fiozera/FZsatellite/README.md

# FZsatellite
Um satélite PocketQube Open Hardware

Projeto desenvolvido em colaboração com:

- Jonathan Querubina <https://github.com/chr0nu5>
- Pedro Kaled <https://github.com/pedrokdc>
- Edson Pavoni

Licensed under CERN-OHL-S v2 or later
