fiozera/FZsatellite/3d_models/suport_mod.stl

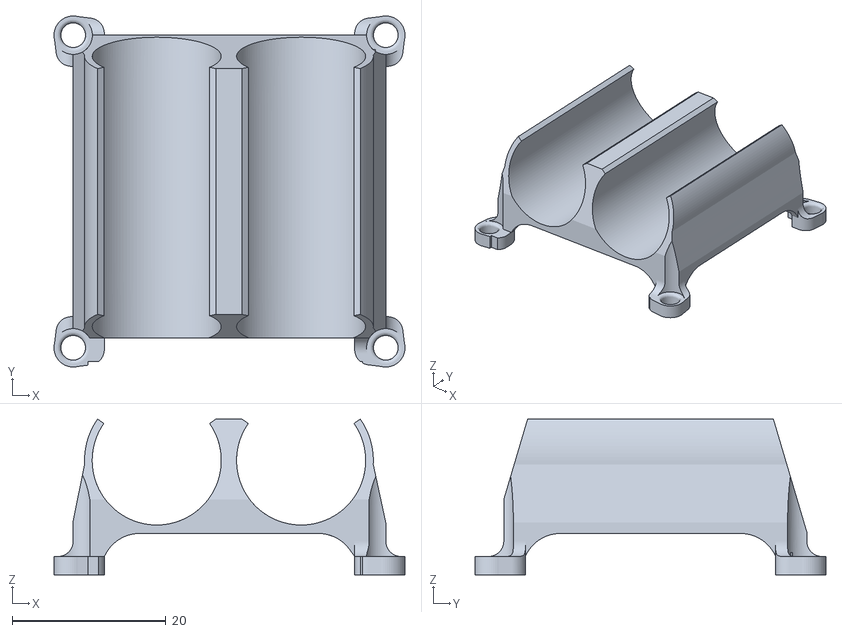
[picture p1: CAD file, 2022-11-08]
3d_models/suport_mod.stl
45.7 x 45.7 x 20.3
