fiozera/FZsatellite/kicad_files/PANEL-COMPLETE.kicad_pcb

## KiCad design kicad_files/PANEL-COMPLETE.kicad_pcb (2022-12-25)

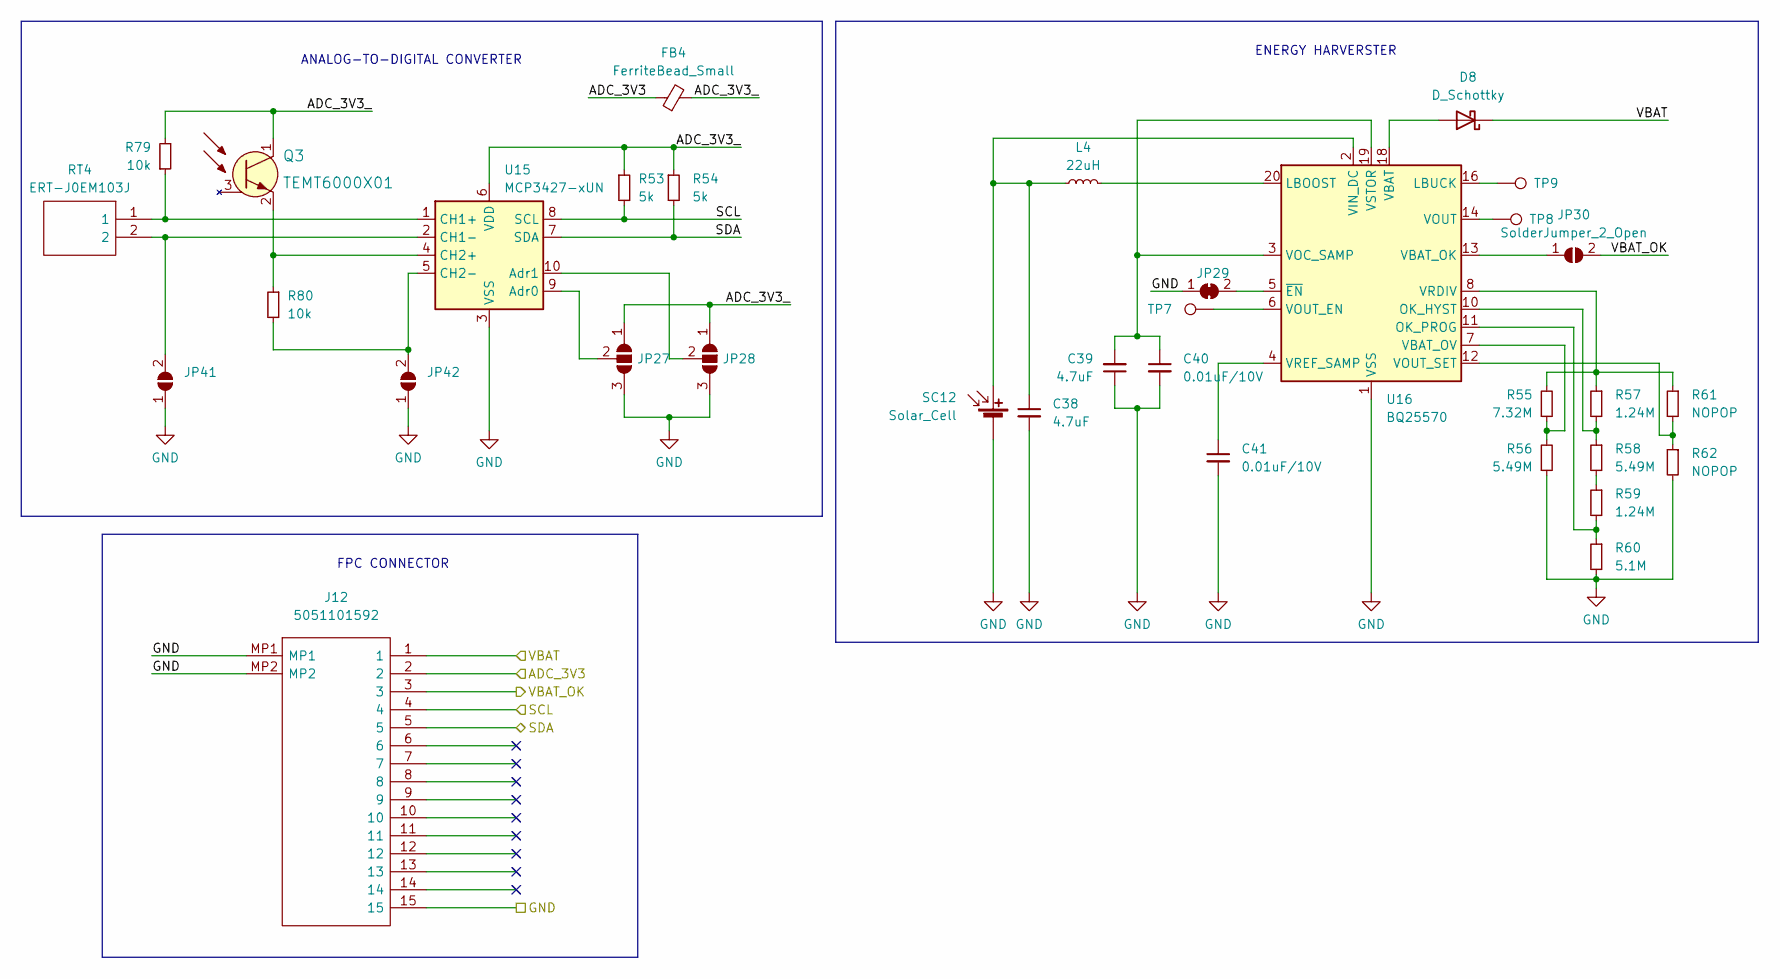
[picture p2: schematic eps_b.kicad_sch, FZSatellite]

Parts:
C38, C39: 4.7uF; C_0805_2012Metric
C40, C41: 0.01uF/10V; C_0402_1005Metric; Mouser Part 581-0402ZC103MAT2A
D8: D_Schottky; D_SOD-323
FB4: FerriteBead_Small; L_0603_1608Metric
J12: 5051101592; Manufacturer_Part_Number 5051101592
JP27, JP28: SolderJumper_3_Open; SolderJumper-3_P1.3mm_Open_RoundedPad1.0x1.5mm
JP29: SolderJumper_2_Bridged; SolderJumper-2_P1.3mm_Bridged_RoundedPad1.0x1.5mm
JP30, JP41, JP42: SolderJumper_2_Open; SolderJumper-2_P1.3mm_Open_RoundedPad1.0x1.5mm
L4: 22uH; LPS4018223MRC
Q3: TEMT6000X01; Phototransistor_SMD_4x2mm_TEMT6000X01; MPN TEMT6000X01; Digi-Key_PN 751-1055-1-ND
R53, R54: 5k; R_0402_1005Metric; Mouser Part 603-RC0402FR-075KL
R55: 7.32M; R_0402_1005Metric
R56, R58: 5.49M; R_0402_1005Metric
R57, R59: 1.24M; R_0402_1005Metric
R60: 5.1M; R_0402_1005Metric
R61, R62: NOPOP; R_0402_1005Metric
R79, R80: 10k; R_0603_1608Metric
RT4: ERT-J0EM103J; THRMC1005X55N; Mouser Part Number 667-ERT-J0EM103J
SC12: Solar_Cell; SM141K08LV
TP7, TP8, TP9: TestPoint; TestPoint_Pad_D1.0mm
U15: MCP3427-xUN; MSOP-10_3x3mm_P0.5mm
U16: BQ25570; QFN-20-1EP_3.5x3.5mm_P0.5mm_EP2x2mm

Connections:
/ADC_3V3: FB4.1, J12.2; also elsewhere on the board
/DEPNO: D8.1 (K), J12.1; also elsewhere on the board
/EPS B/ADC_3V3_: FB4.2, JP27.1 (A), JP28.1 (A), Q3.1 (C), R53.1, R54.1, R79.2, U15.6 (VDD)
/SCL1: J12.4, R53.2, U15.8 (SCL); also elsewhere on the board
/SDA1: J12.5, R54.2, U15.7 (SDA); also elsewhere on the board
/VBAT_OK: J12.3, JP30.2 (B); also elsewhere on the board
GND: C38.2, C39.1, C40.2, C41.2, J12.15, J12.MP1, J12.MP2, JP27.3 (B), JP28.3 (B), JP29.1 (A), JP41.1 (A), JP42.1 (A), R56.1, R60.2, R62.2, SC12.2 (-), U15.3 (VSS), U16.1 (VSS), U16.9 (VSS), U16.15 (VSS), U16.17 (VSS), U16.21 (VSS); also elsewhere on the board
unnamed: C38.1, L4.1, SC12.1 (+), U16.2 (VIN_DC)
unnamed: C39.2, C40.1, U16.3 (VOC_SAMP), U16.19 (VSTOR)
unnamed: C41.1, U16.4 (VREF_SAMP)
unnamed: D8.2 (A), U16.18 (VBAT)
unnamed: JP27.2 (C), U15.9 (Adr0)
unnamed: JP28.2 (C), U15.10 (Adr1)
unnamed: JP29.2 (B), U16.5 (~EN)
unnamed: JP30.1 (A), U16.13 (VBAT_OK)
unnamed: JP41.2 (B), RT4.2, U15.2 (CH1-)
unnamed: JP42.2 (B), R80.2, U15.5 (CH2-)
unnamed: L4.2, U16.20 (LBOOST)
unnamed: Q3.2 (E), R80.1, U15.4 (CH2+)
unnamed: R55.1, R56.2, U16.7 (VBAT_OV)
unnamed: R55.2, R57.1, R61.1, U16.8 (VRDIV)
unnamed: R57.2, R58.1, U16.10 (OK_HYST)
unnamed: R58.2, R59.1
unnamed: R59.2, R60.1, U16.11 (OK_PROG)
unnamed: R61.2, R62.1, U16.12 (VOUT_SET)
unnamed: R79.1, RT4.1, U15.1 (CH1+)
unnamed: TP7.1, U16.6 (VOUT_EN)
unnamed: TP8.1, U16.14 (VOUT)
unnamed: TP9.1, U16.16 (LBUCK)

Notes on the sheet:
FPC CONNECTOR
ANALOG-TO-DIGITAL CONVERTER
ENERGY HARVERSTER

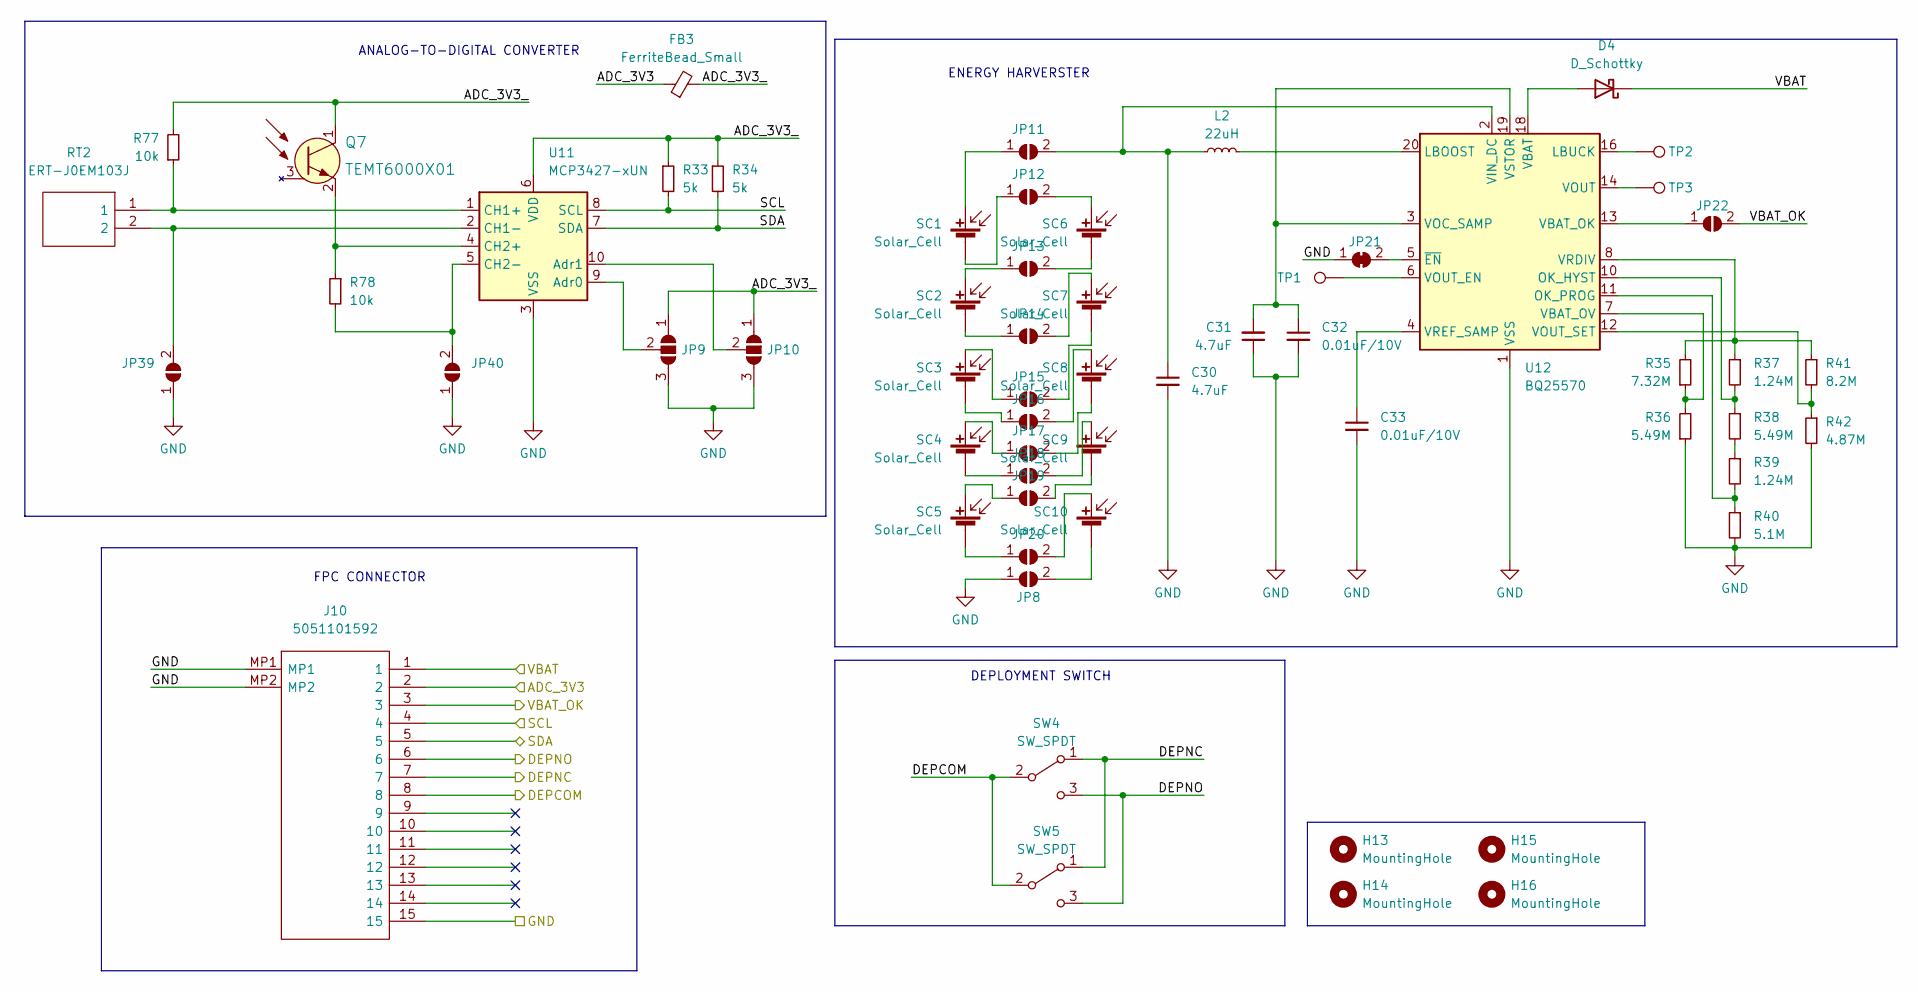
[picture p3: schematic backplane.kicad_sch, FZSatellite]

Parts:
C30, C31: 4.7uF; C_0805_2012Metric
C32, C33: 0.01uF/10V; C_0402_1005Metric; Mouser Part 581-0402ZC103MAT2A
D4: D_Schottky; D_SOD-323
FB3: FerriteBead_Small; L_0603_1608Metric
H13, H14, H15, H16: MountingHole; MountingHole_2.2mm_M2
J10: 5051101592; Manufacturer_Part_Number 5051101592
JP8, JP11, JP12, JP13, JP14, JP15, JP16, JP17, JP18, JP19, JP20, JP22, JP39, JP40: SolderJumper_2_Open; SolderJumper-2_P1.3mm_Open_RoundedPad1.0x1.5mm
JP9, JP10: SolderJumper_3_Open; SolderJumper-3_P1.3mm_Open_RoundedPad1.0x1.5mm
JP21: SolderJumper_2_Bridged; SolderJumper-2_P1.3mm_Bridged_RoundedPad1.0x1.5mm
L2: 22uH; LPS4018223MRC
Q7: TEMT6000X01; Phototransistor_SMD_4x2mm_TEMT6000X01; MPN TEMT6000X01; Digi-Key_PN 751-1055-1-ND
R33, R34: 5k; R_0402_1005Metric; Mouser Part 603-RC0402FR-075KL
R35: 7.32M; R_0402_1005Metric
R36, R38: 5.49M; R_0402_1005Metric
R37, R39: 1.24M; R_0402_1005Metric
R40: 5.1M; R_0402_1005Metric
R41: 8.2M; R_0402_1005Metric
R42: 4.87M; R_0402_1005Metric
R77, R78: 10k; R_0603_1608Metric
RT2: ERT-J0EM103J; THRMC1005X55N; Mouser Part Number 667-ERT-J0EM103J
SC1, SC2, SC3, SC4, SC5, SC6, SC7, SC8, SC9, SC10: Solar_Cell; KXOB25-12X1F-TR
SW4, SW5: SW_SPDT; D2F-L2-A1
TP1, TP2, TP3: TestPoint; TestPoint_Pad_D1.0mm
U11: MCP3427-xUN; MSOP-10_3x3mm_P0.5mm
U12: BQ25570; QFN-20-1EP_3.5x3.5mm_P0.5mm_EP2x2mm

Connections:
/ADC_3V3: FB3.1, J10.2; also elsewhere on the board
/BACK PLANE/ADC_3V3_: FB3.2, JP9.1 (A), JP10.1 (A), Q7.1 (C), R33.1, R34.1, R77.2, U11.6 (VDD)
/DEPCOM: J10.8, SW4.2 (B), SW5.2 (B); also elsewhere on the board
/DEPNC: J10.7, SW4.1 (A), SW5.1 (A); also elsewhere on the board
/DEPNO: D4.1 (K), J10.1, J10.6, SW4.3 (C), SW5.3 (C); also elsewhere on the board
/SCL1: J10.4, R33.2, U11.8 (SCL); also elsewhere on the board
/SDA1: J10.5, R34.2, U11.7 (SDA); also elsewhere on the board
/VBAT_OK: J10.3, JP22.2 (B); also elsewhere on the board
GND: C30.2, C31.1, C32.2, C33.2, J10.15, J10.MP1, J10.MP2, JP8.1 (A), JP9.3 (B), JP10.3 (B), JP21.1 (A), JP39.1 (A), JP40.1 (A), R36.1, R40.2, R42.2, U11.3 (VSS), U12.1 (VSS), U12.9 (VSS), U12.15 (VSS), U12.17 (VSS), U12.21 (VSS); also elsewhere on the board
unnamed: C30.1, JP11.2 (B), L2.1, U12.2 (VIN_DC)
unnamed: C31.2, C32.1, U12.3 (VOC_SAMP), U12.19 (VSTOR)
unnamed: C33.1, U12.4 (VREF_SAMP)
unnamed: D4.2 (A), U12.18 (VBAT)
unnamed: JP8.2 (B), SC10.2 (-)
unnamed: JP9.2 (C), U11.9 (Adr0)
unnamed: JP10.2 (C), U11.10 (Adr1)
unnamed: JP11.1 (A), SC1.1 (+)
unnamed: JP12.1 (A), SC1.2 (-)
unnamed: JP12.2 (B), SC6.1 (+)
unnamed: JP13.1 (A), SC2.1 (+)
unnamed: JP13.2 (B), SC6.2 (-)
unnamed: JP14.1 (A), SC2.2 (-)
unnamed: JP14.2 (B), SC7.1 (+)
unnamed: JP15.1 (A), SC3.1 (+)
unnamed: JP15.2 (B), SC7.2 (-)
unnamed: JP16.1 (A), SC3.2 (-)
unnamed: JP16.2 (B), SC8.1 (+)
unnamed: JP17.1 (A), SC4.1 (+)
unnamed: JP17.2 (B), SC8.2 (-)
unnamed: JP18.1 (A), SC4.2 (-)
unnamed: JP18.2 (B), SC9.1 (+)
unnamed: JP19.1 (A), SC5.1 (+)
unnamed: JP19.2 (B), SC9.2 (-)
unnamed: JP20.1 (A), SC5.2 (-)
unnamed: JP20.2 (B), SC10.1 (+)
unnamed: JP21.2 (B), U12.5 (~EN)
unnamed: JP22.1 (A), U12.13 (VBAT_OK)
unnamed: JP39.2 (B), RT2.2, U11.2 (CH1-)
unnamed: JP40.2 (B), R78.2, U11.5 (CH2-)
unnamed: L2.2, U12.20 (LBOOST)
unnamed: Q7.2 (E), R78.1, U11.4 (CH2+)
unnamed: R35.1, R36.2, U12.7 (VBAT_OV)
unnamed: R35.2, R37.1, R41.1, U12.8 (VRDIV)
unnamed: R37.2, R38.1, U12.10 (OK_HYST)
unnamed: R38.2, R39.1
unnamed: R39.2, R40.1, U12.11 (OK_PROG)
unnamed: R41.2, R42.1, U12.12 (VOUT_SET)
unnamed: R77.1, RT2.1, U11.1 (CH1+)
unnamed: TP1.1, U12.6 (VOUT_EN)
unnamed: TP2.1, U12.16 (LBUCK)
unnamed: TP3.1, U12.14 (VOUT)

Notes on the sheet:
DEPLOYMENT SWITCH
ANALOG-TO-DIGITAL CONVERTER
FPC CONNECTOR
ENERGY HARVERSTER

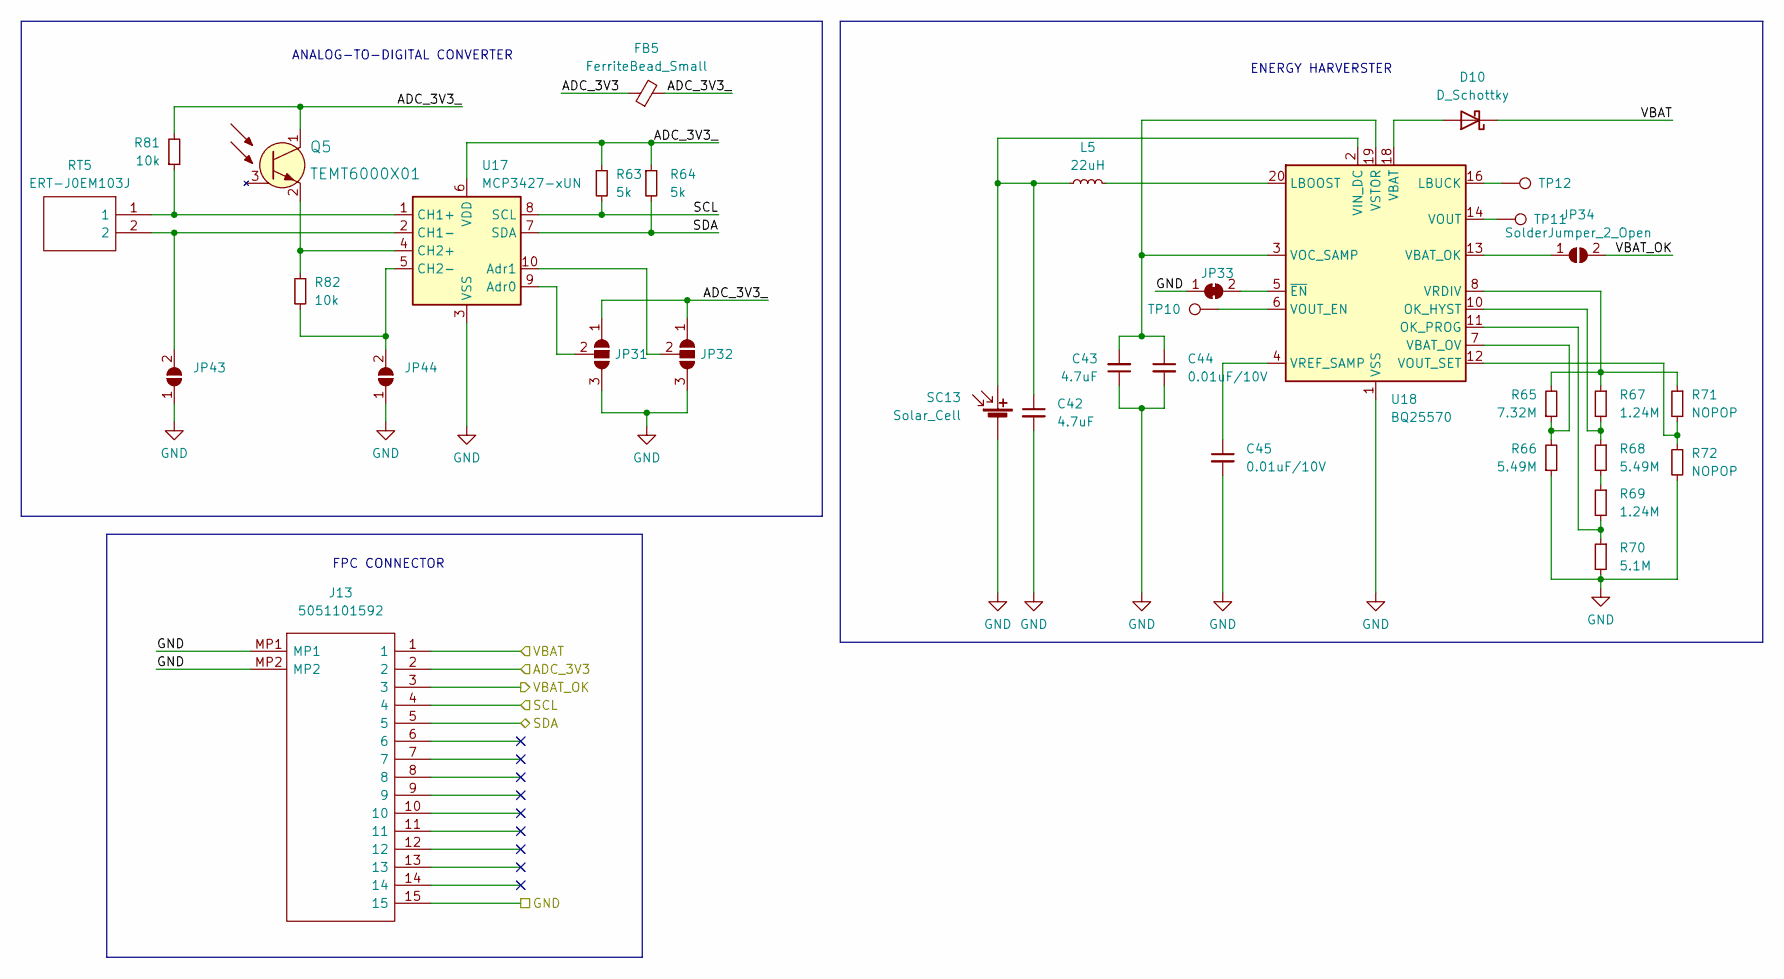
[picture p4: schematic eps_c.kicad_sch, FZSatellite]

Parts:
C42, C43: 4.7uF; C_0805_2012Metric
C44, C45: 0.01uF/10V; C_0402_1005Metric; Mouser Part 581-0402ZC103MAT2A
D10: D_Schottky; D_SOD-323
FB5: FerriteBead_Small; L_0603_1608Metric
J13: 5051101592; Manufacturer_Part_Number 5051101592
JP31, JP32: SolderJumper_3_Open; SolderJumper-3_P1.3mm_Open_RoundedPad1.0x1.5mm
JP33: SolderJumper_2_Bridged; SolderJumper-2_P1.3mm_Bridged_RoundedPad1.0x1.5mm
JP34, JP43, JP44: SolderJumper_2_Open; SolderJumper-2_P1.3mm_Open_RoundedPad1.0x1.5mm
L5: 22uH; LPS4018223MRC
Q5: TEMT6000X01; Phototransistor_SMD_4x2mm_TEMT6000X01; MPN TEMT6000X01; Digi-Key_PN 751-1055-1-ND
R63, R64: 5k; R_0402_1005Metric; Mouser Part 603-RC0402FR-075KL
R65: 7.32M; R_0402_1005Metric
R66, R68: 5.49M; R_0402_1005Metric
R67, R69: 1.24M; R_0402_1005Metric
R70: 5.1M; R_0402_1005Metric
R71, R72: NOPOP; R_0402_1005Metric
R81, R82: 10k; R_0603_1608Metric
RT5: ERT-J0EM103J; THRMC1005X55N; Mouser Part Number 667-ERT-J0EM103J
SC13: Solar_Cell; SM141K08LV
TP10, TP11, TP12: TestPoint; TestPoint_Pad_D1.0mm
U17: MCP3427-xUN; MSOP-10_3x3mm_P0.5mm
U18: BQ25570; QFN-20-1EP_3.5x3.5mm_P0.5mm_EP2x2mm

Connections:
/ADC_3V3: FB5.1, J13.2; also elsewhere on the board
/DEPNO: D10.1 (K), J13.1; also elsewhere on the board
/EPS C/ADC_3V3_: FB5.2, JP31.1 (A), JP32.1 (A), Q5.1 (C), R63.1, R64.1, R81.2, U17.6 (VDD)
/SCL1: J13.4, R63.2, U17.8 (SCL); also elsewhere on the board
/SDA1: J13.5, R64.2, U17.7 (SDA); also elsewhere on the board
/VBAT_OK: J13.3, JP34.2 (B); also elsewhere on the board
GND: C42.2, C43.1, C44.2, C45.2, J13.15, J13.MP1, J13.MP2, JP31.3 (B), JP32.3 (B), JP33.1 (A), JP43.1 (A), JP44.1 (A), R66.1, R70.2, R72.2, SC13.2 (-), U17.3 (VSS), U18.1 (VSS), U18.9 (VSS), U18.15 (VSS), U18.17 (VSS), U18.21 (VSS); also elsewhere on the board
unnamed: C42.1, L5.1, SC13.1 (+), U18.2 (VIN_DC)
unnamed: C43.2, C44.1, U18.3 (VOC_SAMP), U18.19 (VSTOR)
unnamed: C45.1, U18.4 (VREF_SAMP)
unnamed: D10.2 (A), U18.18 (VBAT)
unnamed: JP31.2 (C), U17.9 (Adr0)
unnamed: JP32.2 (C), U17.10 (Adr1)
unnamed: JP33.2 (B), U18.5 (~EN)
unnamed: JP34.1 (A), U18.13 (VBAT_OK)
unnamed: JP43.2 (B), RT5.2, U17.2 (CH1-)
unnamed: JP44.2 (B), R82.2, U17.5 (CH2-)
unnamed: L5.2, U18.20 (LBOOST)
unnamed: Q5.2 (E), R82.1, U17.4 (CH2+)
unnamed: R65.1, R66.2, U18.7 (VBAT_OV)
unnamed: R65.2, R67.1, R71.1, U18.8 (VRDIV)
unnamed: R67.2, R68.1, U18.10 (OK_HYST)
unnamed: R68.2, R69.1
unnamed: R69.2, R70.1, U18.11 (OK_PROG)
unnamed: R71.2, R72.1, U18.12 (VOUT_SET)
unnamed: R81.1, RT5.1, U17.1 (CH1+)
unnamed: TP10.1, U18.6 (VOUT_EN)
unnamed: TP11.1, U18.14 (VOUT)
unnamed: TP12.1, U18.16 (LBUCK)

Notes on the sheet:
ANALOG-TO-DIGITAL CONVERTER
FPC CONNECTOR
ENERGY HARVERSTER

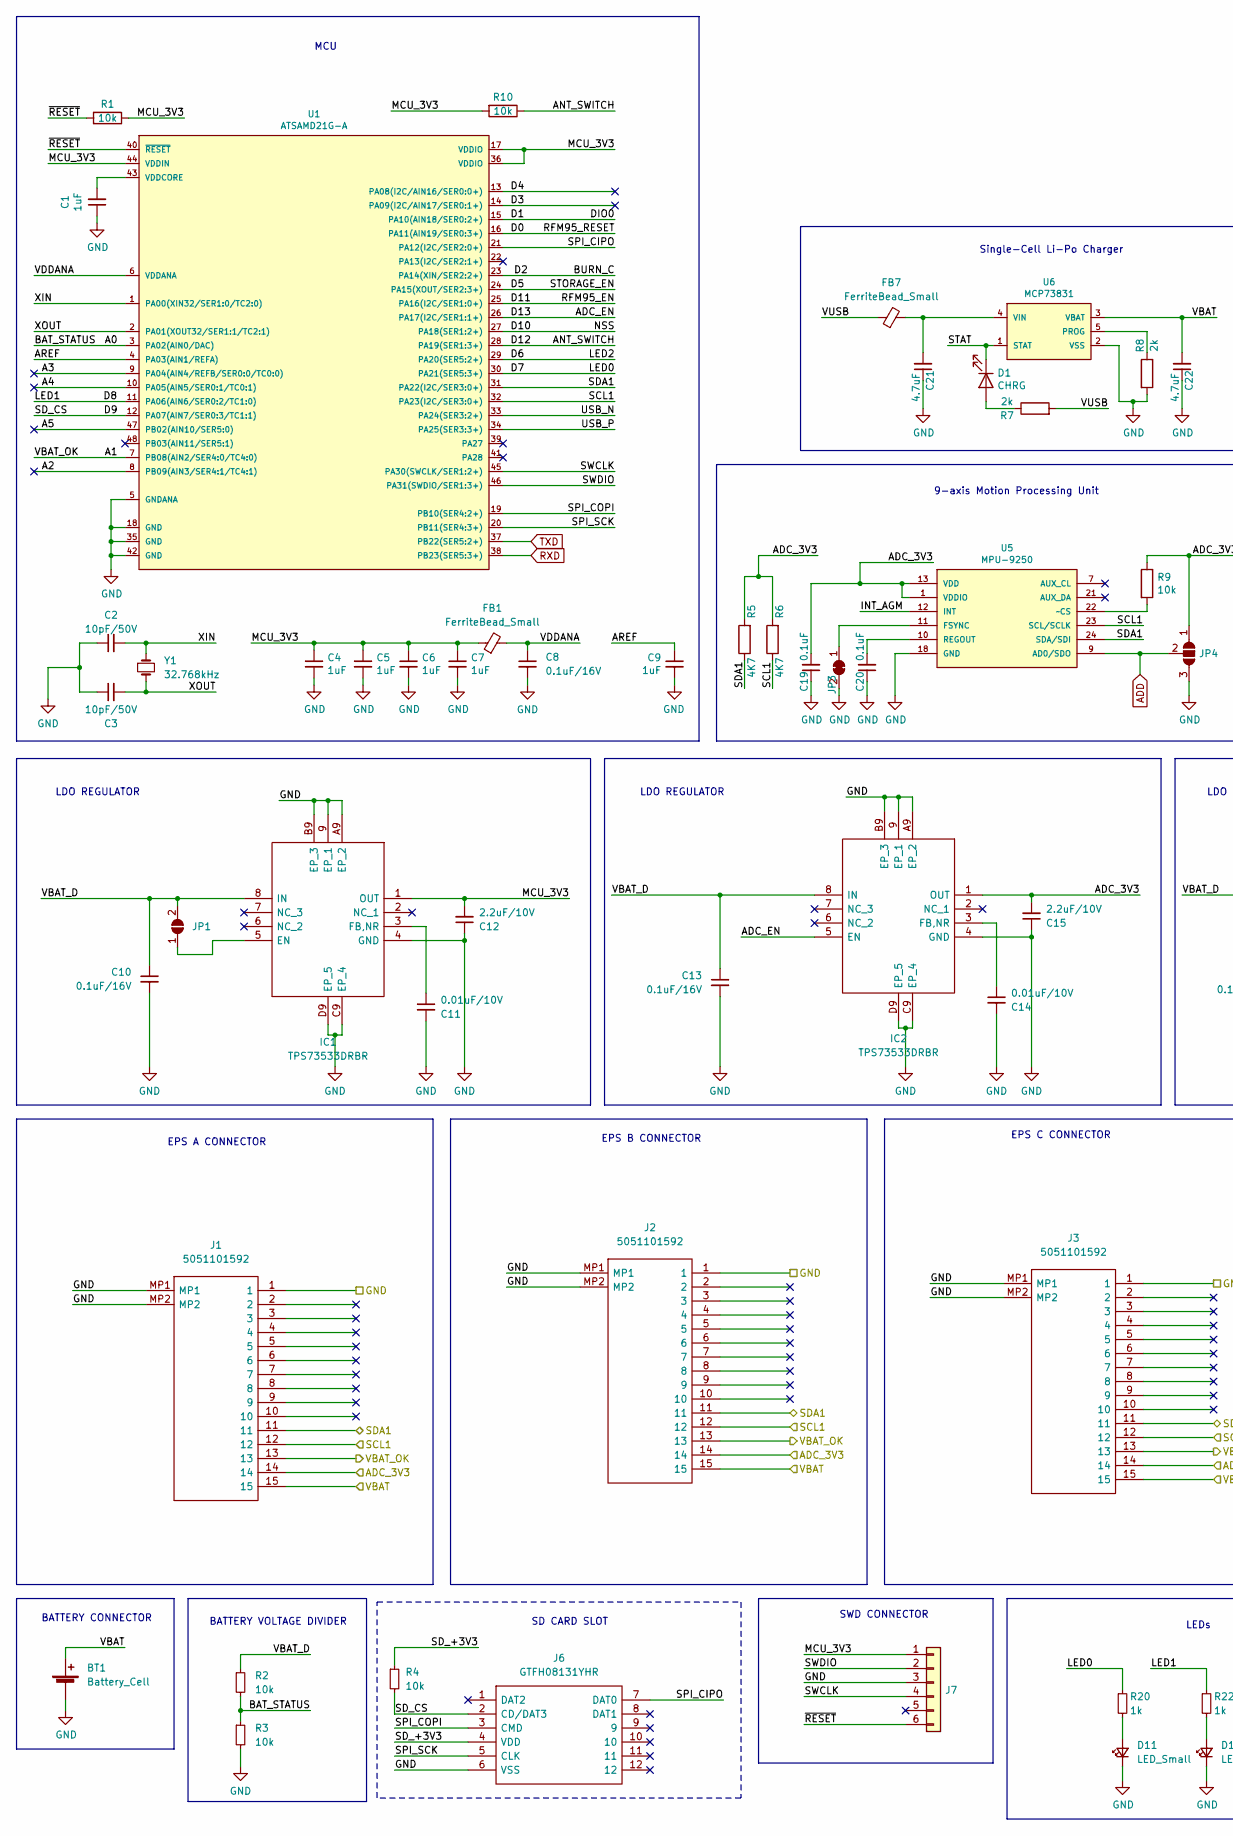
[picture p5: schematic obdh.kicad_sch, FZSatellite, part in row 1, column 1]

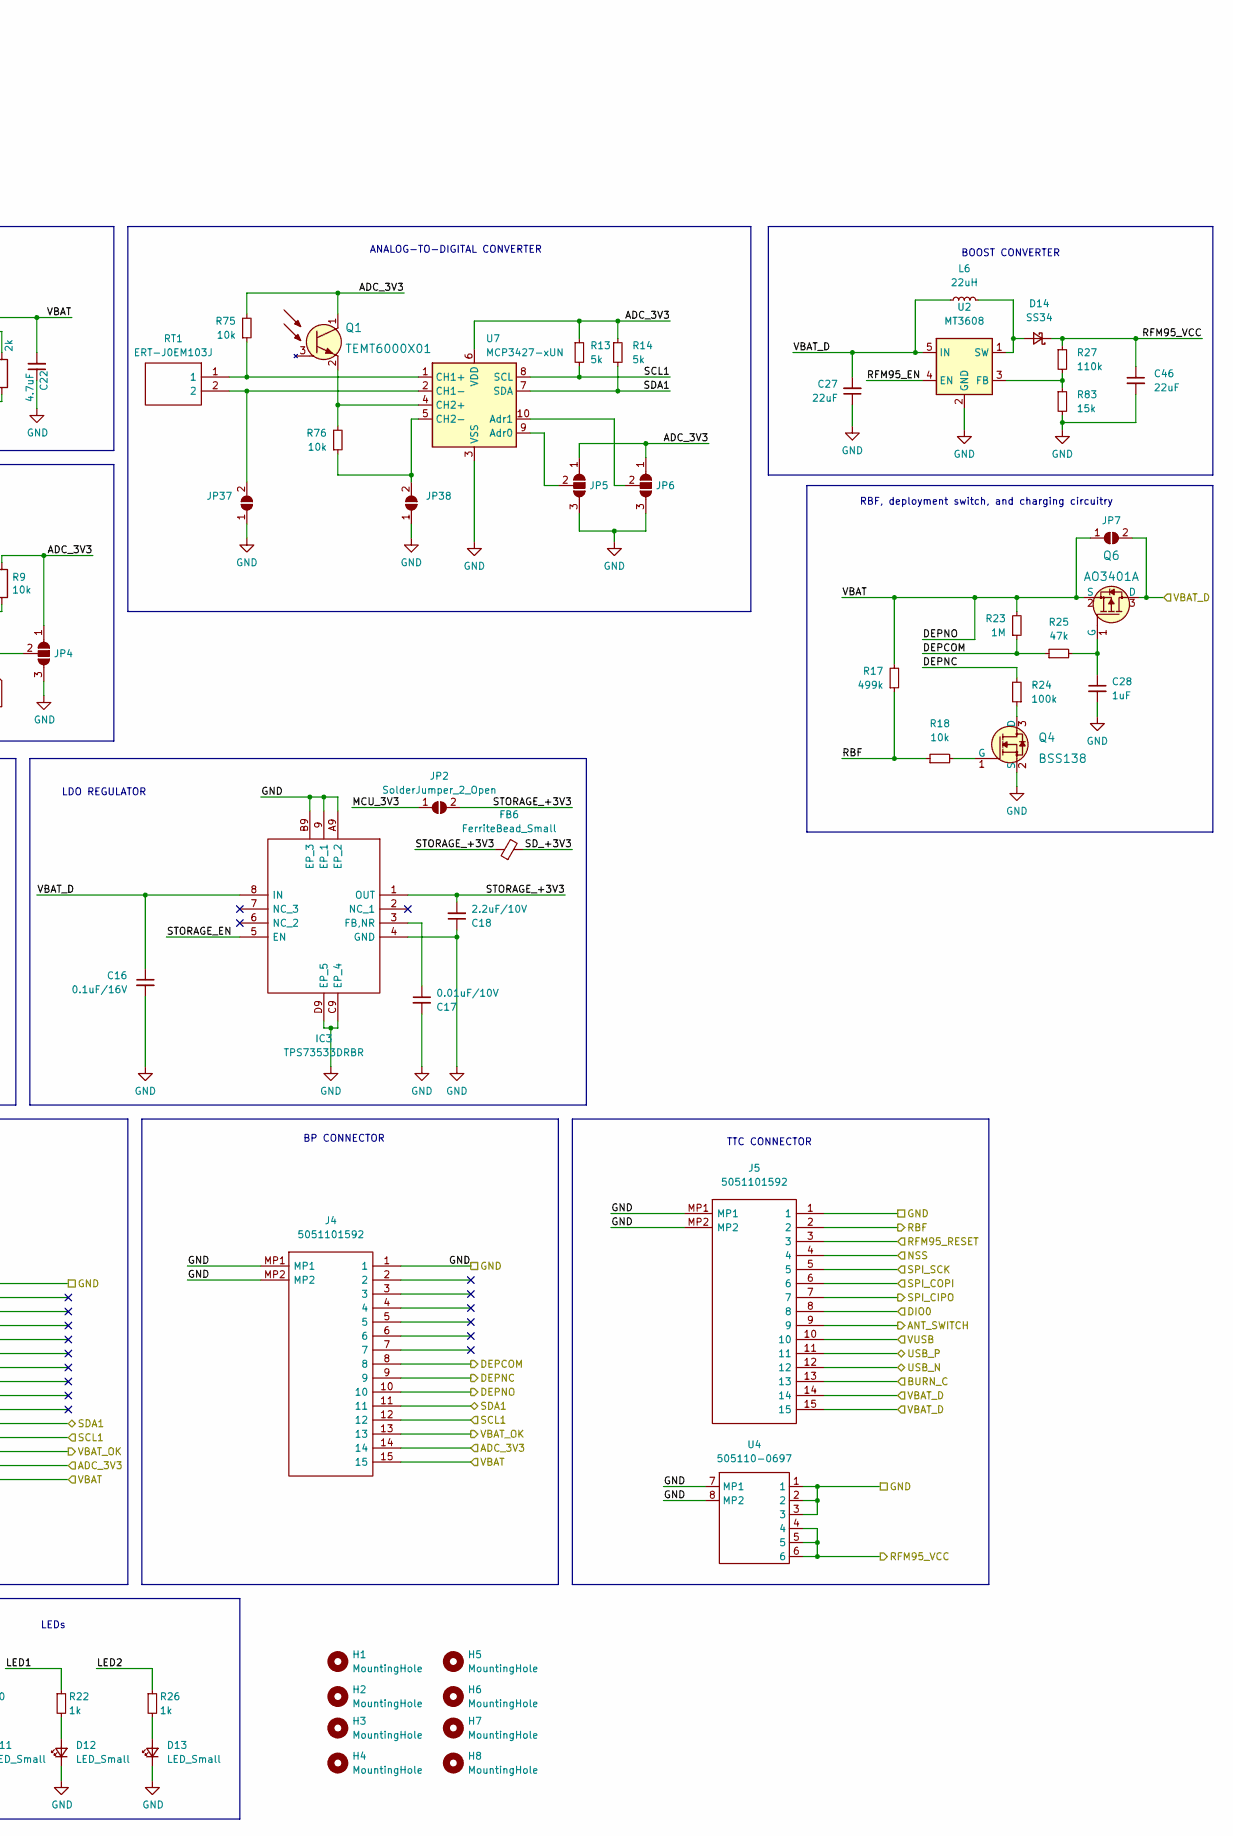
[picture p6: schematic obdh.kicad_sch, FZSatellite, part in row 1, column 2]

Parts:
BT1: Battery_Cell; JST_PH_B2B-PH-K_1x02_P2.00mm_Vertical
C1, C4, C5, C6, C7, C9, C28: 1uF; C_0603_1608Metric
C2, C3: 10pF/50V; C_0402_1005Metric; Mouser Part 81-GCM1555C1H100JA6D
C8, C10, C13, C16: 0.1uF/16V; C_0402_1005Metric; Mouser Part 81-GCM155R71C104KA5D
C11, C14, C17: 0.01uF/10V; C_0402_1005Metric; Mouser Part 581-0402ZC103MAT2A
C12, C15, C18: 2.2uF/10V; C_0603_1608Metric; Mouser Part 81-GRM188R71A225KE15
C19, C20: 0.1uF; C_0603_1608Metric
C21, C22: 4.7uF; C_0603_1608Metric
C27, C46: 22uF; C_1206_3216Metric
D1: CHRG; LED_0603_1608Metric
D11, D12, D13: LED_Small; LED_0603_1608Metric
D14: SS34; D_SMA
FB1, FB6, FB7: FerriteBead_Small; L_0603_1608Metric
H1, H2, H3, H4, H5, H6, H7, H8: MountingHole; MountingHole_2.2mm_M2
IC1, IC2, IC3: TPS73533DRBR; Mouser Part Number 595-TPS73533DRBR
J1, J2, J3, J4, J5: 5051101592; Manufacturer_Part_Number 5051101592
J6: GTFH08131YHR; Mouser Part Number 523-GTFH08131YHR
J7: Conn_01x06; Tag-Connect_TC2030-IDC-NL_2x03_P1.27mm_Vertical
JP1, JP2, JP7, JP37, JP38: SolderJumper_2_Open; SolderJumper-2_P1.3mm_Open_RoundedPad1.0x1.5mm
JP3: SolderJumper_2_Bridged; SolderJumper-2_P1.3mm_Bridged_RoundedPad1.0x1.5mm
JP4, JP5, JP6: SolderJumper_3_Open; SolderJumper-3_P1.3mm_Open_RoundedPad1.0x1.5mm
L6: 22uH; L_6.3x6.3_H3
Q1: TEMT6000X01; Phototransistor_SMD_4x2mm_TEMT6000X01; MPN TEMT6000X01; Digi-Key_PN 751-1055-1-ND
Q4: BSS138; SOT-23-3; MPN BSS138; Digi-Key_PN BSS138CT-ND
Q6: AO3401A; SOT-23-3; MPN AO3401A; Digi-Key_PN 785-1001-1-ND
R1, R2, R3, R9, R10, R18, R75, R76: 10k; R_0603_1608Metric
R4: 10k; R_0402_1005Metric; Mouser Part 603-RC0402FR-1010KL
R5, R6: 4K7; R_0603_1608Metric
R7, R8: 2k; R_0603_1608Metric
R13, R14: 5k; R_0402_1005Metric; Mouser Part 603-RC0402FR-075KL
R17: 499k; R_0603_1608Metric
R20, R22, R26: 1k; R_0603_1608Metric
R23: 1M; R_0603_1608Metric
R24: 100k; R_0603_1608Metric
R25: 47k; R_0603_1608Metric
R27: 110k; R_0603_1608Metric
R83: 15k; R_0603_1608Metric
RT1: ERT-J0EM103J; THRMC1005X55N; Mouser Part Number 667-ERT-J0EM103J
U1: ATSAMD21G-A; TQFP-48_7x7mm_P0.5mm
U2: MT3608; SOT-23-6
U4: 505110-0697; 5051100692
U5: MPU-9250; QFN-24-1EP_3x3mm_P0.4mm_EP1.75x1.6mm
U6: MCP73831; SOT23-5
U7: MCP3427-xUN; MSOP-10_3x3mm_P0.5mm
Y1: 32.768kHz; Crystal_SMD_2012-2Pin_2.0x1.2mm; Mouser Part 710-830062558

Connections:
/ADC_3V3: C15.2, C19.2, IC2.1 (OUT), J1.14, J2.14, J3.14, J4.14, JP4.1 (A), JP5.1 (A), JP6.1 (A), Q1.1 (C), R5.2, R6.2, R9.1, R13.1, R14.1, R75.2, U5.1 (VDDIO), U5.8 (VDDIO), U5.13 (VDD), U7.6 (VDD); also elsewhere on the board
/ANT_SWITCH: J5.9, R10.1, U1.28 (PA19(SER1:3+)); also elsewhere on the board
/BURN_C: J5.13, U1.23 (PA14(XIN/SER2:2+)); also elsewhere on the board
/DEPCOM: J4.8, R23.1, R25.1; also elsewhere on the board
/DEPNC: J4.9, R24.2; also elsewhere on the board
/DEPNO: BT1.1 (+), C22.2, J1.15, J2.15, J3.15, J4.10, J4.15, JP7.1 (A), Q6.2 (S), R17.2, R23.2, U6.3 (VBAT); also elsewhere on the board
/DIO0: J5.8, U1.15 (PA10(AIN18/SER0:2+)); also elsewhere on the board
/NSS: J5.4, U1.27 (PA18(SER1:2+)); also elsewhere on the board
/OBDH/A0: R2.2, R3.1, U1.3 (PA02(AIN0/DAC))
/OBDH/A2: U1.8 (PB09(AIN3/SER4:1/TC4:1))
/OBDH/A3: U1.9 (PA04(AIN4/REFB/SER0:0/TC0:0))
/OBDH/A4: U1.10 (PA05(AIN5/SER0:1/TC0:1))
/OBDH/A5: U1.47 (PB02(AIN10/SER5:0))
/OBDH/ADC_EN: IC2.5 (EN), U1.26 (PA17(I2C/SER1:1+))
/OBDH/AREF: C9.1, U1.4 (PA03(AIN1/REFA))
/OBDH/D3: U1.14 (PA09(I2C/AIN17/SER0:1+))
/OBDH/D4: U1.13 (PA08(I2C/AIN16/SER0:0+))
/OBDH/D5: IC3.5 (EN), U1.24 (PA15(XOUT/SER2:3+))
/OBDH/D6: R26.1, U1.29 (PA20(SER5:2+))
/OBDH/D7: R20.1, U1.30 (PA21(SER5:3+))
/OBDH/D8: R22.1, U1.11 (PA06(AIN6/SER0:2/TC1:0))
/OBDH/D9: J6.2 (CD/DAT3), R4.2, U1.12 (PA07(AIN7/SER0:3/TC1:1))
/OBDH/D11: U1.25 (PA16(I2C/SER1:0+)), U2.4 (EN)
/OBDH/INT_AGM: U5.12 (INT)
/OBDH/MCU_3V3: C4.1, C5.1, C6.1, C7.1, C12.2, FB1.1, IC1.1 (OUT), J7.1, JP2.1 (A), R1.1, R10.2, U1.17 (VDDIO), U1.36 (VDDIO), U1.44 (VDDIN)
/OBDH/SD_+3V3: FB6.2, J6.4 (VDD), R4.1
/OBDH/STAT: D1.1 (K), U6.1 (STAT)
/OBDH/STORAGE_+3V3: C18.2, FB6.1, IC3.1 (OUT), JP2.2 (B)
/OBDH/SWCLK: J7.4, U1.45 (PA30(SWCLK/SER1:2+))
/OBDH/SWDIO: J7.2, U1.46 (PA31(SWDIO/SER1:3+))
/OBDH/VDDANA: C8.1, FB1.2, U1.6 (VDDANA)
/OBDH/XIN: C2.2, U1.1 (PA00(XIN32/SER1:0/TC2:0)), Y1.1
/OBDH/XOUT: C3.2, U1.2 (PA01(XOUT32/SER1:1/TC2:1)), Y1.2
/OBDH/~RESET: J7.6, R1.2, U1.40 (~RESET)
/RBF: J5.2, R17.1, R18.1; also elsewhere on the board
/RFM95_RESET: J5.3, U1.16 (PA11(AIN19/SER0:3+)); also elsewhere on the board
/RFM95_VCC: C46.1, D14.1 (K), R27.1, U4.4, U4.5, U4.6; also elsewhere on the board
/SCL1: J1.12, J2.12, J3.12, J4.12, R6.1, R13.2, U1.32 (PA23(I2C/SER3:0+)), U5.23 (SCL/SCLK), U7.8 (SCL); also elsewhere on the board
/SDA1: J1.11, J2.11, J3.11, J4.11, R5.1, R14.2, U1.31 (PA22(I2C/SER3:0+)), U5.24 (SDA/SDI), U7.7 (SDA); also elsewhere on the board
/SPI_CIPO: J5.7, J6.7 (DAT0), U1.21 (PA12(I2C/SER2:0+)); also elsewhere on the board
/SPI_COPI: J5.6, J6.3 (CMD), U1.19 (PB10(SER4:2+)); also elsewhere on the board
/SPI_SCK: J5.5, J6.5 (CLK), U1.20 (PB11(SER4:3+)); also elsewhere on the board
/USB_N: J5.12, U1.33 (PA24(SER3:2+)); also elsewhere on the board
/USB_P: J5.11, U1.34 (PA25(SER3:3+)); also elsewhere on the board
/VBAT_D: C10.1, C13.1, C16.1, C27.2, IC1.8 (IN), IC2.8 (IN), IC3.8 (IN), J5.14, J5.15, JP1.2 (B), JP7.2 (B), L6.1, Q6.3 (D), R2.1, U2.5 (IN); also elsewhere on the board
/VBAT_OK: J1.13, J2.13, J3.13, J4.13, U1.7 (PB08(AIN2/SER4:0/TC4:0)); also elsewhere on the board
/VUSB: FB7.1, J5.10, R7.2; also elsewhere on the board
ADD: JP4.2 (C), U5.9 (AD0/SDO)
GND: BT1.2 (-), C1.1, C2.1, C3.1, C4.2, C5.2, C6.2, C7.2, C8.2, C9.2, C10.2, C11.2, C12.1, C13.2, C14.2, C15.1, C16.2, C17.2, C18.1, C19.1, C20.1, C21.1, C22.1, C27.1, C28.2, C46.2, D11.1 (K), D12.1 (K), D13.1 (K), IC1.4 (GND), IC1.9 (EP_1), IC1.A9 (EP_2), IC1.B9 (EP_3), IC1.C9 (EP_4), IC1.D9 (EP_5), IC2.4 (GND), IC2.9 (EP_1), IC2.A9 (EP_2), IC2.B9 (EP_3), IC2.C9 (EP_4), IC2.D9 (EP_5), IC3.4 (GND), IC3.9 (EP_1), IC3.A9 (EP_2), IC3.B9 (EP_3), IC3.C9 (EP_4), IC3.D9 (EP_5), J1.1, J1.MP1, J1.MP2, J2.1, J2.MP1, J2.MP2, J3.1, J3.MP1, J3.MP2, J4.1, J4.MP1, J4.MP2, J5.1, J5.MP1, J5.MP2, J6.6 (VSS), J7.3, JP3.2 (B), JP4.3 (B), JP5.3 (B), JP6.3 (B), JP37.1 (A), JP38.1 (A), Q4.2 (S), R3.2, R8.2, R83.2, U1.5 (GNDANA), U1.18 (GND), U1.35 (GND), U1.42 (GND), U2.2 (GND), U4.1, U4.2, U4.3, U4.7 (MP1), U4.8 (MP2), U5.18 (GND), U5.20 (GND), U6.2 (VSS), U7.3 (VSS); also elsewhere on the board
unnamed: C1.2, U1.43 (VDDCORE)
unnamed: C11.1, IC1.3 (FB,NR)
unnamed: C14.1, IC2.3 (FB,NR)
unnamed: C17.1, IC3.3 (FB,NR)
unnamed: C20.2, U5.10 (REGOUT)
unnamed: C21.2, FB7.2, U6.4 (VIN)
unnamed: C28.1, Q6.1 (G), R25.2
unnamed: D1.2 (A), R7.1
unnamed: D11.2 (A), R20.2
unnamed: D12.2 (A), R22.2
unnamed: D13.2 (A), R26.2
unnamed: D14.2 (A), L6.2, U2.1 (SW)
unnamed: IC1.5 (EN), JP1.1 (A)
unnamed: JP3.1 (A), U5.11 (FSYNC)
unnamed: JP5.2 (C), U7.9 (Adr0)
unnamed: JP6.2 (C), U7.10 (Adr1)
unnamed: JP37.2 (B), RT1.2, U7.2 (CH1-)
unnamed: JP38.2 (B), R76.1, U7.5 (CH2-)
unnamed: Q1.2 (E), R76.2, U7.4 (CH2+)
unnamed: Q4.1 (G), R18.2
unnamed: Q4.3 (D), R24.1
unnamed: R8.1, U6.5 (PROG)
unnamed: R9.2, U5.22 (~CS)
unnamed: R27.2, R83.1, U2.3 (FB)
unnamed: R75.1, RT1.1, U7.1 (CH1+)
RXD: U1.38 (PB23(SER5:3+))
TXD: U1.37 (PB22(SER5:2+))

Notes on the sheet:
LEDs
BATTERY CONNECTOR
RBF, deployment switch, and charging circuitry
BATTERY VOLTAGE DIVIDER
EPS B CONNECTOR
SD CARD SLOT
MCU
9-axis Motion Processing Unit
TTC CONNECTOR
SWD CONNECTOR
BOOST CONVERTER
ANALOG-TO-DIGITAL CONVERTER
Single-Cell Li-Po Charger
LDO REGULATOR
BP CONNECTOR
EPS A CONNECTOR
EPS C CONNECTOR
