fiozera/FZsatellite/kicad_files/PANEL-COMPLETE.kicad_pcb

## KiCad design kicad_files/PANEL-COMPLETE.kicad_pcb (continued)

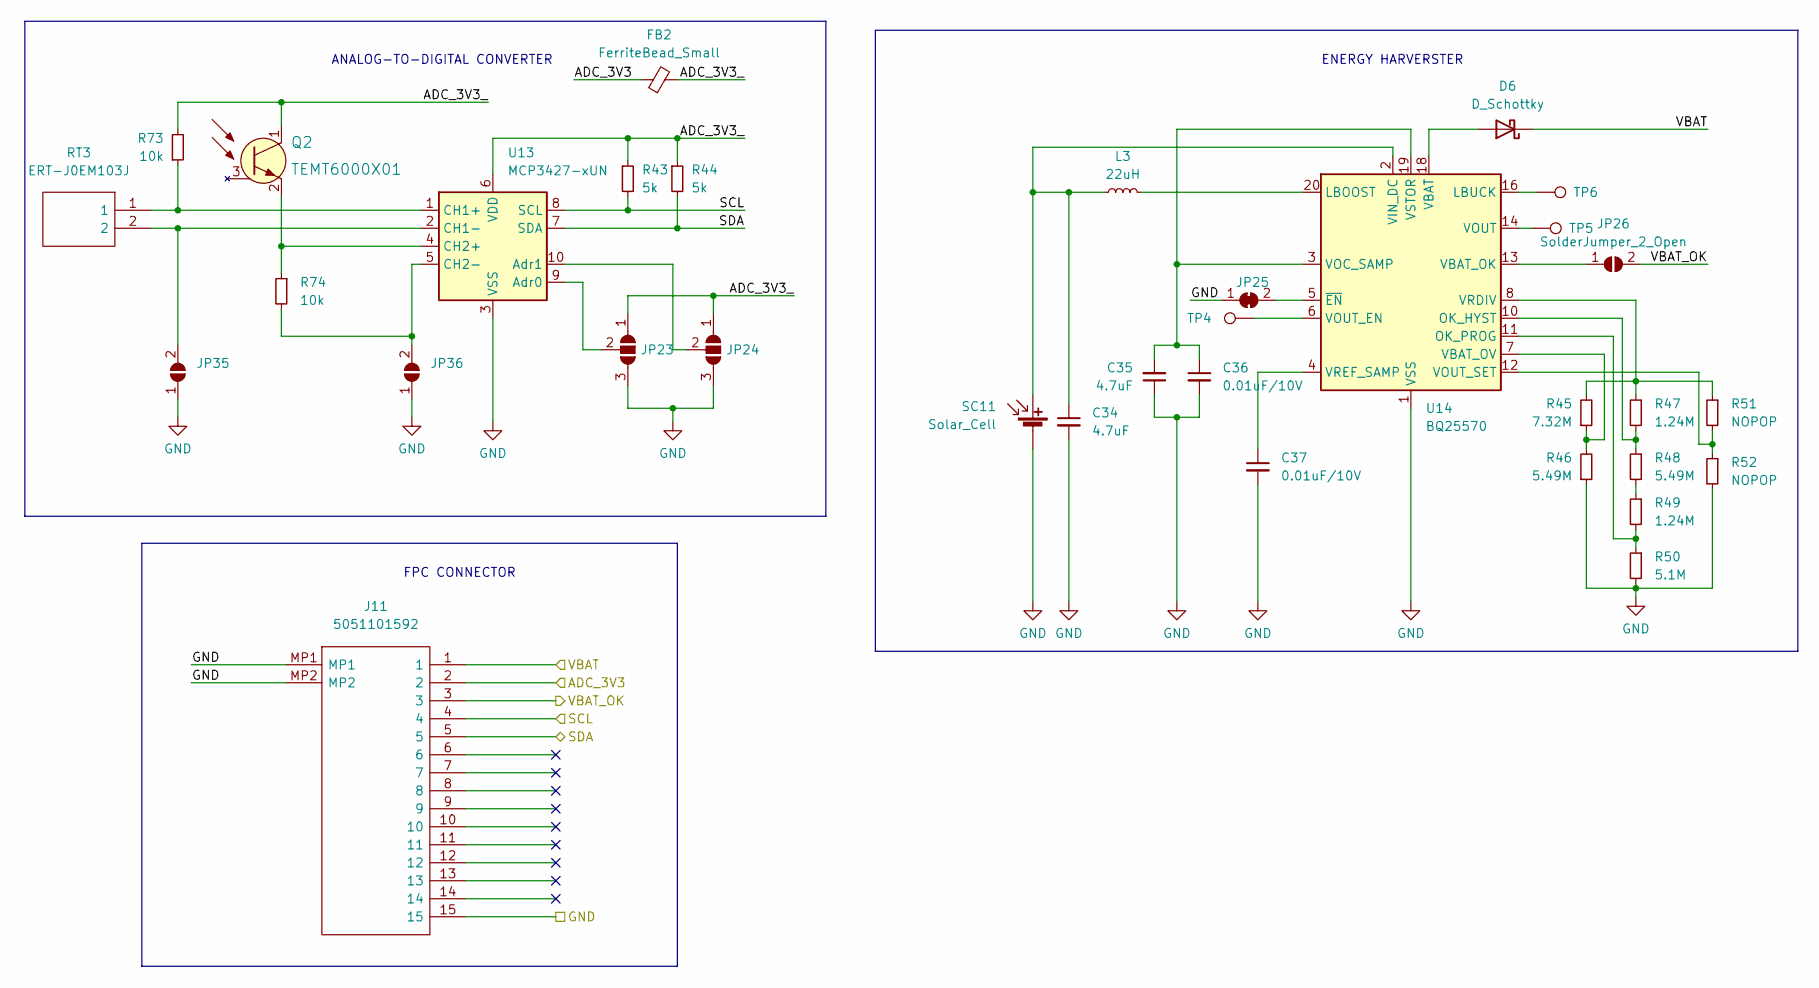
[picture p7: schematic eps_a.kicad_sch, FZSatellite]

Parts:
C34, C35: 4.7uF; C_0805_2012Metric
C36, C37: 0.01uF/10V; C_0402_1005Metric; Mouser Part 581-0402ZC103MAT2A
D6: D_Schottky; D_SOD-323
FB2: FerriteBead_Small; L_0603_1608Metric
J11: 5051101592; Manufacturer_Part_Number 5051101592
JP23, JP24: SolderJumper_3_Open; SolderJumper-3_P1.3mm_Open_RoundedPad1.0x1.5mm
JP25: SolderJumper_2_Bridged; SolderJumper-2_P1.3mm_Bridged_RoundedPad1.0x1.5mm
JP26, JP35, JP36: SolderJumper_2_Open; SolderJumper-2_P1.3mm_Open_RoundedPad1.0x1.5mm
L3: 22uH; LPS4018223MRC
Q2: TEMT6000X01; Phototransistor_SMD_4x2mm_TEMT6000X01; MPN TEMT6000X01; Digi-Key_PN 751-1055-1-ND
R43, R44: 5k; R_0402_1005Metric; Mouser Part 603-RC0402FR-075KL
R45: 7.32M; R_0402_1005Metric
R46, R48: 5.49M; R_0402_1005Metric
R47, R49: 1.24M; R_0402_1005Metric
R50: 5.1M; R_0402_1005Metric
R51, R52: NOPOP; R_0402_1005Metric
R73, R74: 10k; R_0603_1608Metric
RT3: ERT-J0EM103J; THRMC1005X55N; Mouser Part Number 667-ERT-J0EM103J
SC11: Solar_Cell; SM141K08LV
TP4, TP5, TP6: TestPoint; TestPoint_Pad_D1.0mm
U13: MCP3427-xUN; MSOP-10_3x3mm_P0.5mm
U14: BQ25570; QFN-20-1EP_3.5x3.5mm_P0.5mm_EP2x2mm

Connections:
/ADC_3V3: FB2.1, J11.2; also elsewhere on the board
/DEPNO: D6.1 (K), J11.1; also elsewhere on the board
/EPS A/ADC_3V3_: FB2.2, JP23.1 (A), JP24.1 (A), Q2.1 (C), R43.1, R44.1, R73.2, U13.6 (VDD)
/SCL1: J11.4, R43.2, U13.8 (SCL); also elsewhere on the board
/SDA1: J11.5, R44.2, U13.7 (SDA); also elsewhere on the board
/VBAT_OK: J11.3, JP26.2 (B); also elsewhere on the board
GND: C34.2, C35.1, C36.2, C37.2, J11.15, J11.MP1, J11.MP2, JP23.3 (B), JP24.3 (B), JP25.1 (A), JP35.1 (A), JP36.1 (A), R46.1, R50.2, R52.2, SC11.2 (-), U13.3 (VSS), U14.1 (VSS), U14.9 (VSS), U14.15 (VSS), U14.17 (VSS), U14.21 (VSS); also elsewhere on the board
unnamed: C34.1, L3.1, SC11.1 (+), U14.2 (VIN_DC)
unnamed: C35.2, C36.1, U14.3 (VOC_SAMP), U14.19 (VSTOR)
unnamed: C37.1, U14.4 (VREF_SAMP)
unnamed: D6.2 (A), U14.18 (VBAT)
unnamed: JP23.2 (C), U13.9 (Adr0)
unnamed: JP24.2 (C), U13.10 (Adr1)
unnamed: JP25.2 (B), U14.5 (~EN)
unnamed: JP26.1 (A), U14.13 (VBAT_OK)
unnamed: JP35.2 (B), RT3.2, U13.2 (CH1-)
unnamed: JP36.2 (B), R74.2, U13.5 (CH2-)
unnamed: L3.2, U14.20 (LBOOST)
unnamed: Q2.2 (E), R74.1, U13.4 (CH2+)
unnamed: R45.1, R46.2, U14.7 (VBAT_OV)
unnamed: R45.2, R47.1, R51.1, U14.8 (VRDIV)
unnamed: R47.2, R48.1, U14.10 (OK_HYST)
unnamed: R48.2, R49.1
unnamed: R49.2, R50.1, U14.11 (OK_PROG)
unnamed: R51.2, R52.1, U14.12 (VOUT_SET)
unnamed: R73.1, RT3.1, U13.1 (CH1+)
unnamed: TP4.1, U14.6 (VOUT_EN)
unnamed: TP5.1, U14.14 (VOUT)
unnamed: TP6.1, U14.16 (LBUCK)

Notes on the sheet:
ANALOG-TO-DIGITAL CONVERTER
FPC CONNECTOR
ENERGY HARVERSTER

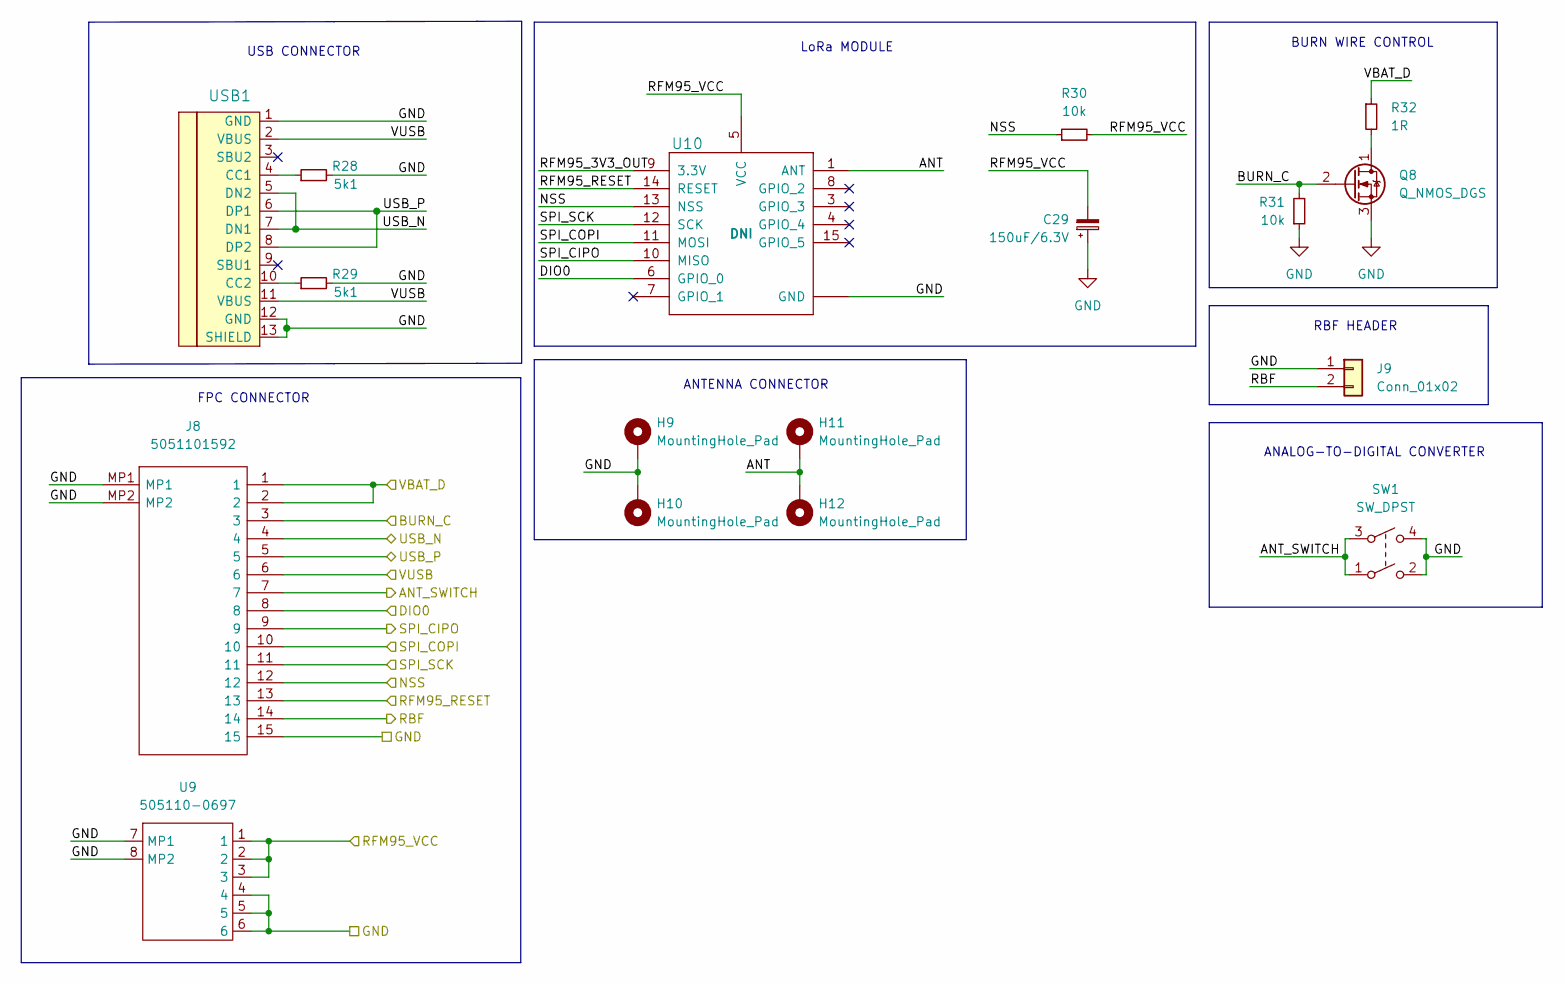
[picture p8: schematic ttc.kicad_sch, FZSatellite]

Parts:
C29: 150uF/6.3V; CP_EIA-7343-15_Kemet-W; Mouser Part 80-T520V157M006E025
H9, H10, H11, H12: MountingHole_Pad; MountingHole_2.2mm_M2_DIN965_Pad_TopOnly
J8: 5051101592; Manufacturer_Part_Number 5051101592
J9: Conn_01x02; PinHeader_1x02_P2.54mm_Horizontal
Q8: Q_NMOS_DGS; RUL035N02FRATR
R28, R29: 5k1; R_0603_1608Metric
R30, R31: 10k; R_0402_1005Metric
R32: 1R; R_Axial_DIN0207_L6.3mm_D2.5mm_P10.16mm_Horizontal
SW1: SW_DPST; SPPB530601
U9: 505110-0697; 5051100692
U10: RFM98PW; RFM95PW
USB1: HRO-TYPE-C-31-M-12; HRO-TYPE-C-31-M-12-HandSoldering

Connections:
/ANT_SWITCH: J8.7, SW1.1, SW1.3; also elsewhere on the board
/BURN_C: J8.3, Q8.2 (G), R31.2; also elsewhere on the board
/DIO0: J8.8, U10.6 (GPIO_0); also elsewhere on the board
/NSS: J8.12, R30.1, U10.13 (NSS); also elsewhere on the board
/RBF: J8.14, J9.2; also elsewhere on the board
/RFM95_RESET: J8.13, U10.14 (RESET); also elsewhere on the board
/RFM95_VCC: C29.2, R30.2, U9.1, U9.2, U9.3, U10.5 (VCC); also elsewhere on the board
/SPI_CIPO: J8.9, U10.10 (MISO); also elsewhere on the board
/SPI_COPI: J8.10, U10.11 (MOSI); also elsewhere on the board
/SPI_SCK: J8.11, U10.12 (SCK); also elsewhere on the board
/TTC/ANT: H11.1, H12.1, U10.1 (ANT)
/TTC/RFM95_3V3_OUT: U10.9 (3.3V)
/USB_N: J8.4, USB1.5 (DN2), USB1.7 (DN1); also elsewhere on the board
/USB_P: J8.5, USB1.6 (DP1), USB1.8 (DP2); also elsewhere on the board
/VBAT_D: J8.1, J8.2, R32.1; also elsewhere on the board
/VUSB: J8.6, USB1.2 (VBUS), USB1.11 (VBUS); also elsewhere on the board
GND: C29.1, H9.1, H10.1, J8.15, J8.MP1, J8.MP2, J9.1, Q8.3 (S), R28.2, R29.2, R31.1, SW1.2, SW1.4, U9.4, U9.5, U9.6, U9.7 (MP1), U9.8 (MP2), U10.2 (GND), U10.16 (GND), U10.17 (GND), USB1.1 (GND), USB1.12 (GND), USB1.13 (SHIELD); also elsewhere on the board
unnamed: Q8.1 (D), R32.2
unnamed: R28.1, USB1.4 (CC1)
unnamed: R29.1, USB1.10 (CC2)

Notes on the sheet:
ANALOG-TO-DIGITAL CONVERTER
BURN WIRE CONTROL
FPC CONNECTOR
RBF HEADER
USB CONNECTOR
LoRa MODULE
ANTENNA CONNECTOR

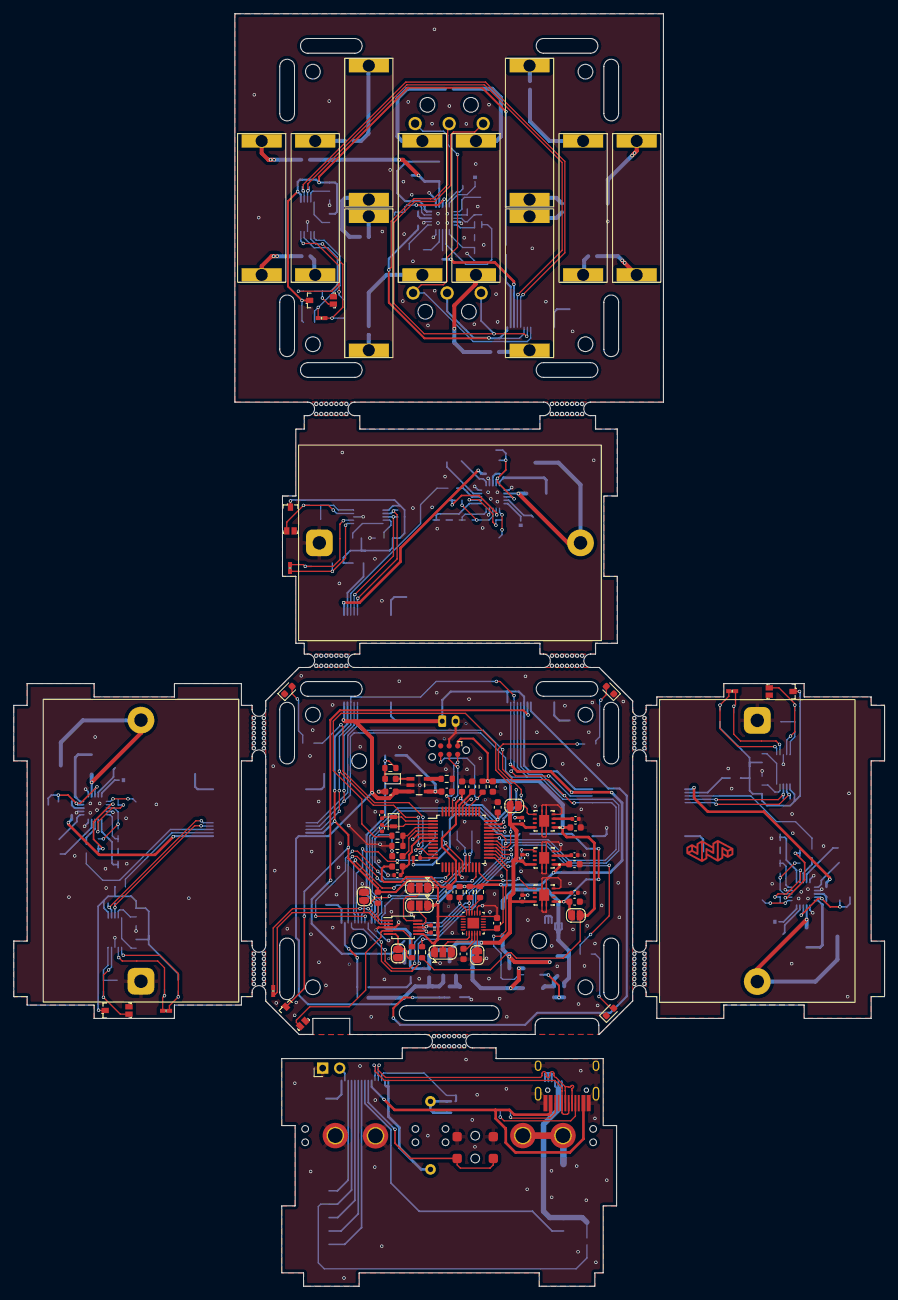
[picture p9: board PANEL-COMPLETE.kicad_pcb from above]

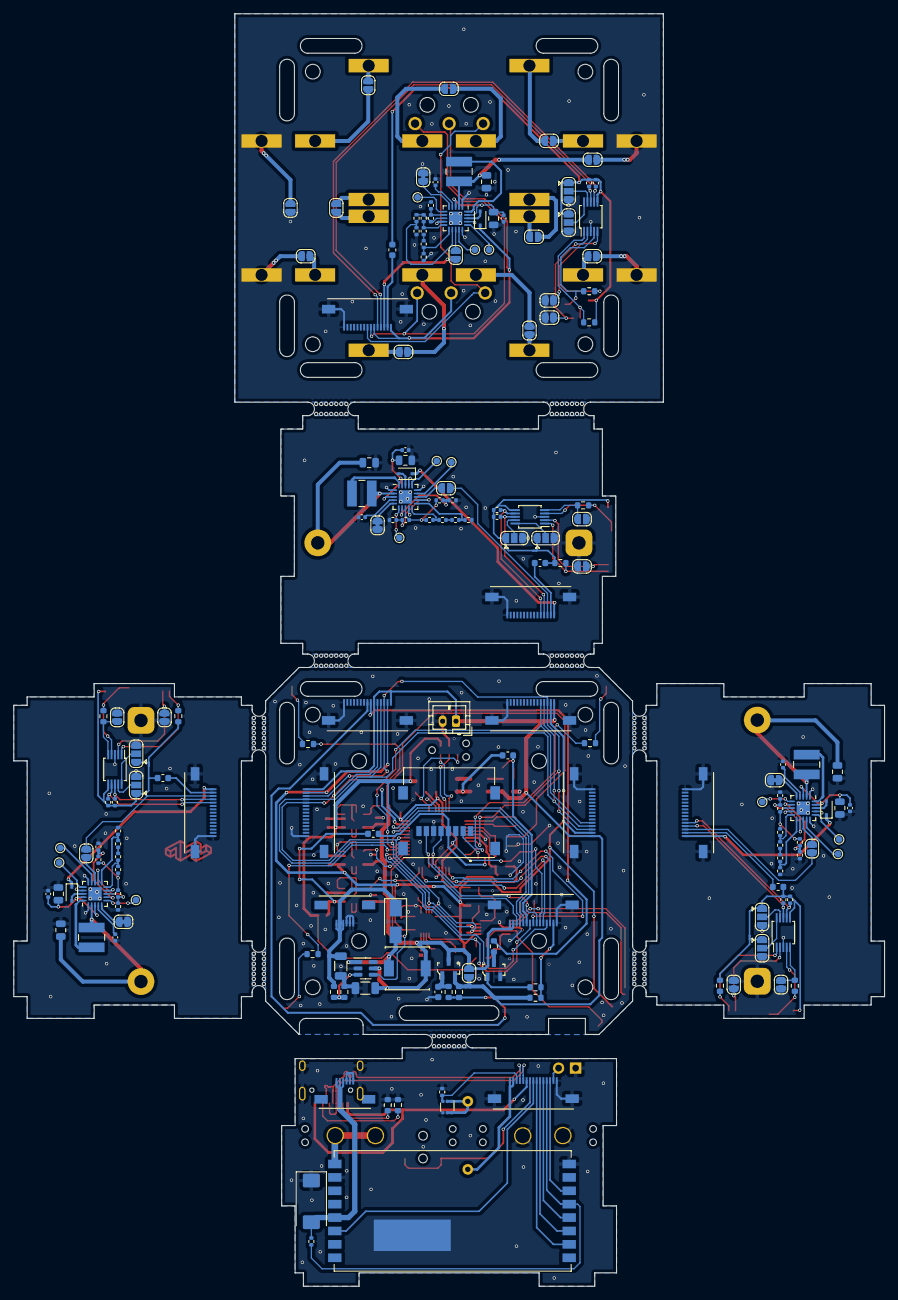
[picture p10: board PANEL-COMPLETE.kicad_pcb from below]

Board: 2 copper layers, 130.0 x 190.0 mm, 285 parts (173 on the bottom side), 183 nets.

Other parts of the board:
mouse-bite-2mm-slot, mouse-bite-2mm-slot#2, mouse-bite-2mm-slot#3, mouse-bite-2mm-slot#4, mouse-bite-2mm-slot#5, mouse-bite-2mm-slot#6, mouse-bite-2mm-slot#7, mouse-bite-2mm-slot#8, mouse-bite-2mm-slot#9: VAL**; mouse-bite-2mm-slot
