fiozera/FZsatellite/bs_transceiver/bs_transceiver.kicad_pcb

## KiCad design bs_transceiver/bs_transceiver.kicad_pcb (2022-11-14)

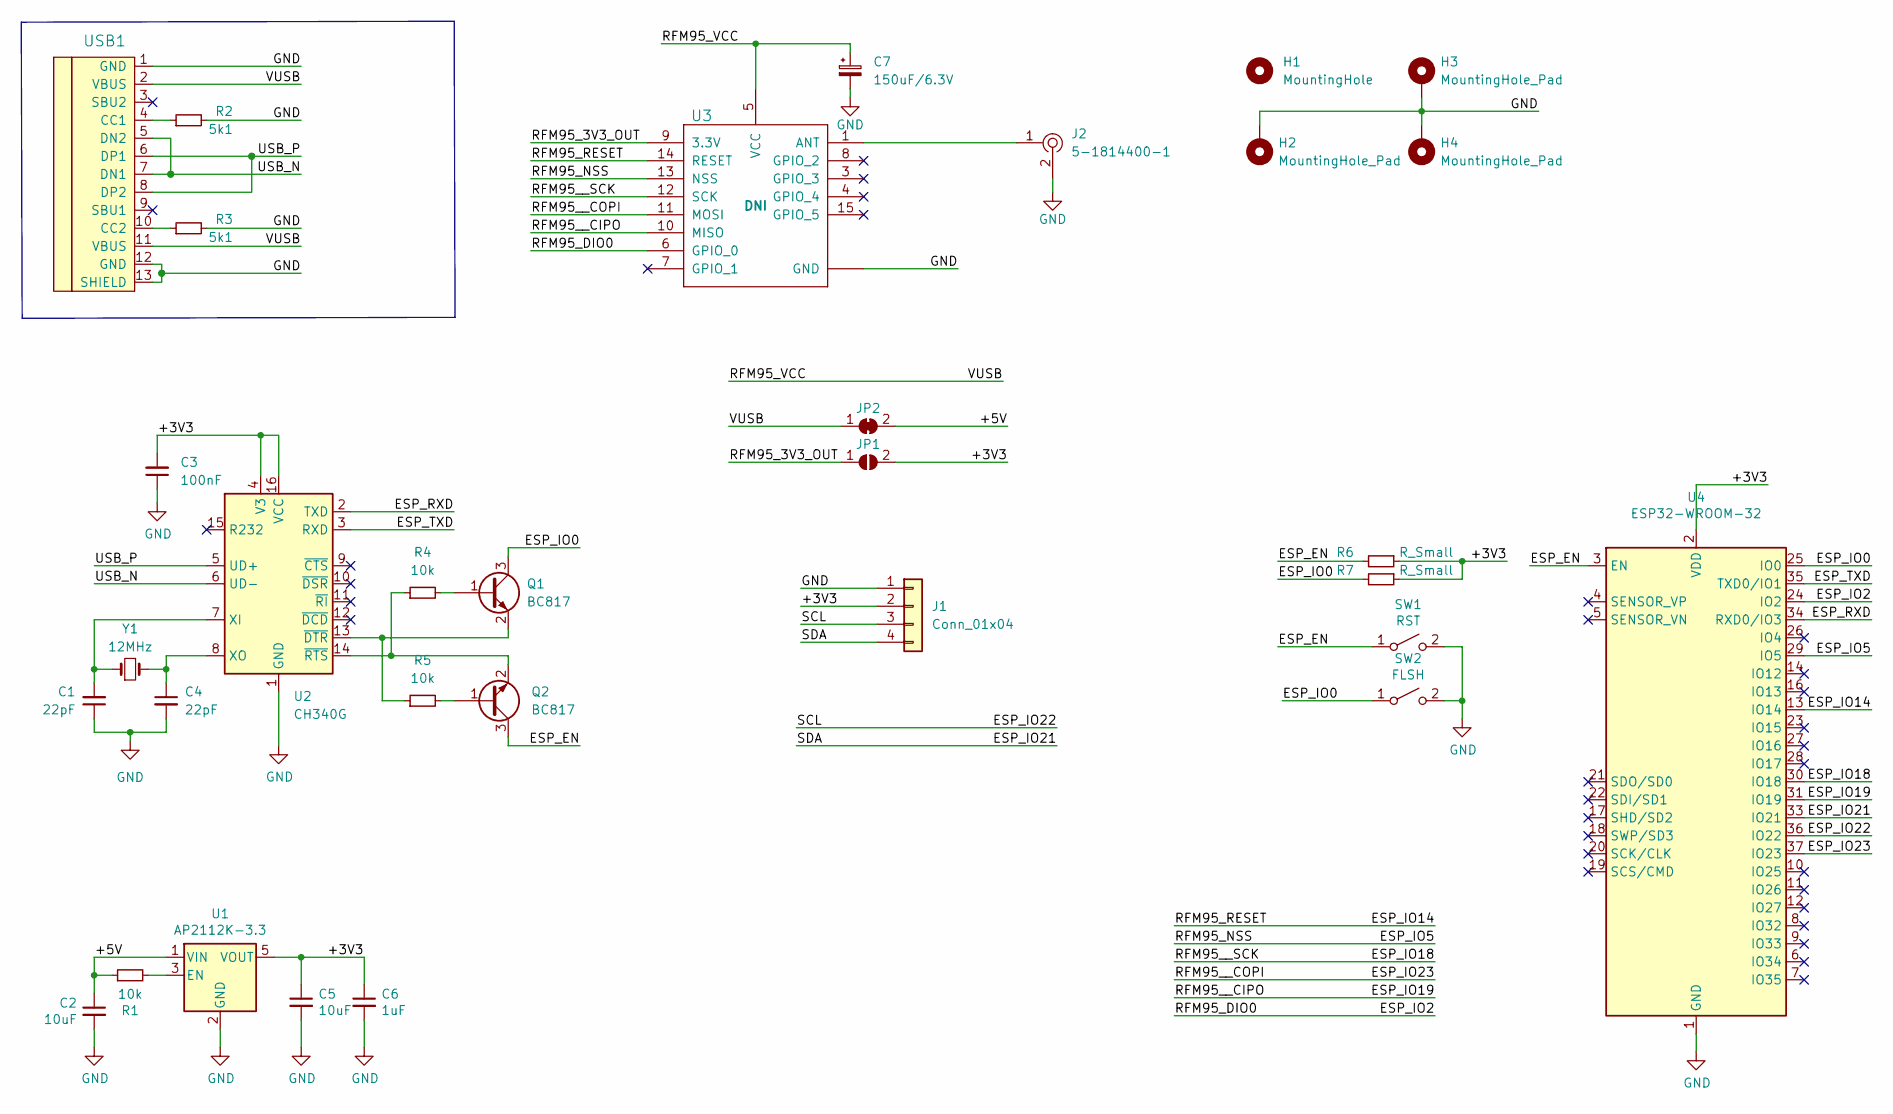
[picture p11: schematic bs_transceiver.kicad_sch, Base Station Transceiver]

Parts:
C1, C4: 22pF; C_0603_1608Metric
C2, C5: 10uF; C_0603_1608Metric
C3: 100nF; C_0603_1608Metric
C6: 1uF; C_0603_1608Metric
C7: 150uF/6.3V; CP_EIA-7343-15_Kemet-W; Mouser Part 80-T520V157M006E025
H1: MountingHole; MountingHole_3.2mm_M3
H2, H3, H4: MountingHole_Pad; MountingHole_3.2mm_M3_DIN965_Pad_TopOnly
J1: Conn_01x04; PinHeader_1x04_P2.54mm_Vertical
J2: 5-1814400-1; RF_SMA_RightAngle_5-1814400-1; MPN 5-1814400-1; Digi-Key_PN A97593-ND
JP1: SolderJumper_2_Open; SolderJumper-2_P1.3mm_Open_RoundedPad1.0x1.5mm
JP2: SolderJumper_2_Bridged; SolderJumper-2_P1.3mm_Bridged_RoundedPad1.0x1.5mm
Q1, Q2: BC817; SOT-23
R1, R4, R5: 10k; R_0603_1608Metric
R2, R3: 5k1; R_0603_1608Metric
R6, R7: R_Small; R_0603_1608Metric
SW1: RST; SW_SPST_FSMSM
SW2: FLSH; SW_SPST_FSMSM
U1: AP2112K-3.3; SOT-23-5
U2: CH340G; SOIC-16_3.9x9.9mm_P1.27mm
U3: RFM98PW; RFM95PW
U4: ESP32-WROOM-32
USB1: HRO-TYPE-C-31-M-12; HRO-TYPE-C-31-M-12-HandSoldering
Y1: 12MHz; Crystal_SMD_HC49-SD

Connections:
/+3V3: C3.2, C5.1, C6.1, J1.2, JP1.2 (B), R6.1, R7.1, U1.5 (VOUT), U2.4 (V3), U2.16 (VCC), U4.2 (VDD)
/+5V: C2.1, JP2.2 (B), R1.1, U1.1 (VIN)
/ESP_EN: Q2.3 (C), R6.2, SW1.1 (A), U4.3 (EN)
/ESP_IO0: Q1.3 (C), R7.2, SW2.1 (A), U4.25 (IO0)
/ESP_IO2: U3.6 (GPIO_0), U4.24 (IO2)
/ESP_IO5: U3.13 (NSS), U4.29 (IO5)
/ESP_IO14: U3.14 (RESET), U4.13 (IO14)
/ESP_IO18: U3.12 (SCK), U4.30 (IO18)
/ESP_IO19: U3.10 (MISO), U4.31 (IO19)
/ESP_IO21: J1.4, U4.33 (IO21)
/ESP_IO22: J1.3, U4.36 (IO22)
/ESP_IO23: U3.11 (MOSI), U4.37 (IO23)
/ESP_RXD: U2.2 (TXD), U4.34 (RXD0/IO3)
/ESP_TXD: U2.3 (RXD), U4.35 (TXD0/IO1)
/RFM95_3V3_OUT: JP1.1 (A), U3.9 (3.3V)
/RFM95_VCC: C7.1, JP2.1 (A), U3.5 (VCC), USB1.2 (VBUS), USB1.11 (VBUS)
/USB_N: U2.6 (UD-), USB1.5 (DN2), USB1.7 (DN1)
/USB_P: U2.5 (UD+), USB1.6 (DP1), USB1.8 (DP2)
GND: C1.1, C2.2, C3.1, C4.2, C5.2, C6.2, C7.2, H2.1, H3.1, H4.1, J1.1, J2.2, R2.2, R3.2, SW1.2 (B), SW2.2 (B), U1.2 (GND), U2.1 (GND), U3.2 (GND), U3.16 (GND), U3.17 (GND), U4.1 (GND), U4.15 (GND), U4.38 (GND), U4.39 (GND), USB1.1 (GND), USB1.12 (GND), USB1.13 (SHIELD)
unnamed: C1.2, U2.7 (XI), Y1.1
unnamed: C4.1, U2.8 (XO), Y1.2
unnamed: J2.1, U3.1 (ANT)
unnamed: Q1.1 (B), R4.2
unnamed: Q1.2 (E), R5.1, U2.13 (~DTR)
unnamed: Q2.1 (B), R5.2
unnamed: Q2.2 (E), R4.1, U2.14 (~RTS)
unnamed: R1.2, U1.3 (EN)
unnamed: R2.1, USB1.4 (CC1)
unnamed: R3.1, USB1.10 (CC2)

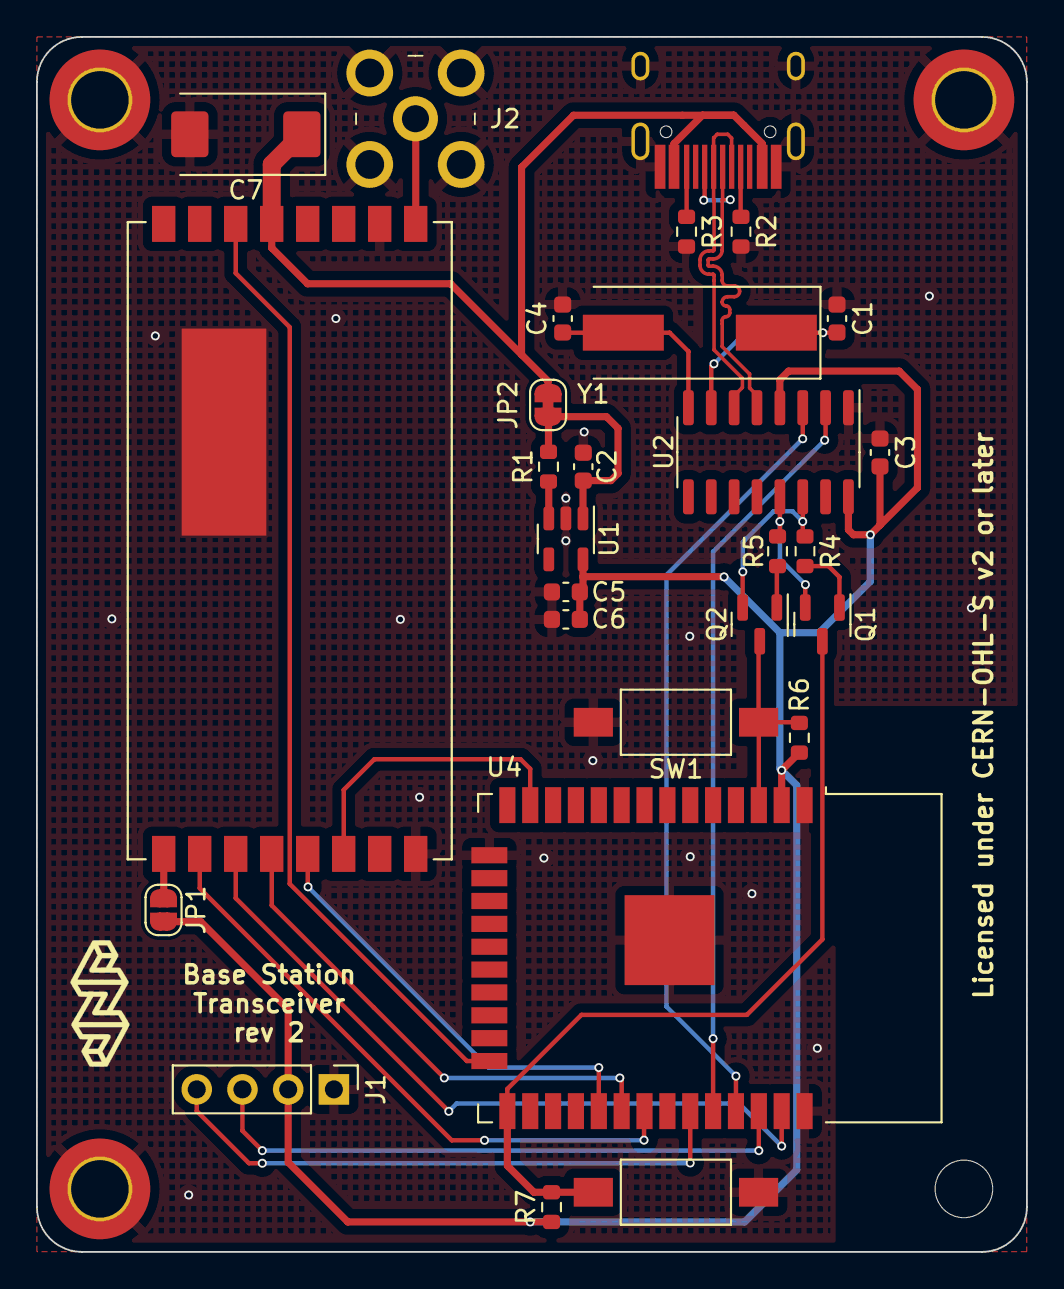
[picture p12: board bs_transceiver.kicad_pcb from above]

Board: 2 copper layers, 55.0 x 67.5 mm, 32 parts (0 on the bottom side), 29 nets.
