fiozera/FZsatellite/(commit log)

2022-11-08 add 3d models
    [suport_mod.stl]
2022-11-09 add gerber and kicad project files
    [PANEL-COMPLETE-B_Cu.gbl, PANEL-COMPLETE-B_Mask.gbs, PANEL-COMPLETE-B_Paste.gbp, PANEL-COMPLETE-B_Silkscreen.gbo, PANEL-COMPLETE-Edge_Cuts.gm1, PANEL-COMPLETE-F_Cu.gtl, PANEL-COMPLETE-F_Mask.gts, PANEL-COMPLETE-F_Paste.gtp]
2022-11-09 update gerber files
    [PANEL-COMPLETE-B_Cu.gbl, PANEL-COMPLETE-B_Mask.gbs, PANEL-COMPLETE-B_Paste.gbp, PANEL-COMPLETE-B_Silkscreen.gbo, PANEL-COMPLETE-Edge_Cuts.gm1, PANEL-COMPLETE-F_Cu.gtl, PANEL-COMPLETE-F_Mask.gts, PANEL-COMPLETE-F_Paste.gtp]
2022-11-09 update kicad files
2022-11-14 add base station transceiver files
    [bs_transceiver-B_Cu.gbl, bs_transceiver-B_Mask.gbs, bs_transceiver-B_Paste.gbp, bs_transceiver-B_Silkscreen.gbo, bs_transceiver-Edge_Cuts.gm1, bs_transceiver-F_Cu.gtl, bs_transceiver-F_Mask.gts, bs_transceiver-F_Paste.gtp]
2022-12-25 update components values
    [PANEL-COMPLETE.csv, PANEL-COMPLETE.kicad_pcb, PANEL-COMPLETE.kicad_sch, backplane.kicad_sch, eps_a.kicad_sch, eps_b.kicad_sch, eps_c.kicad_sch, obdh.kicad_sch]
2022-12-25 add schematics.pdf
